MattiaFunnyM/Phone-Holder/Foxy Holder Topper v1.3mf

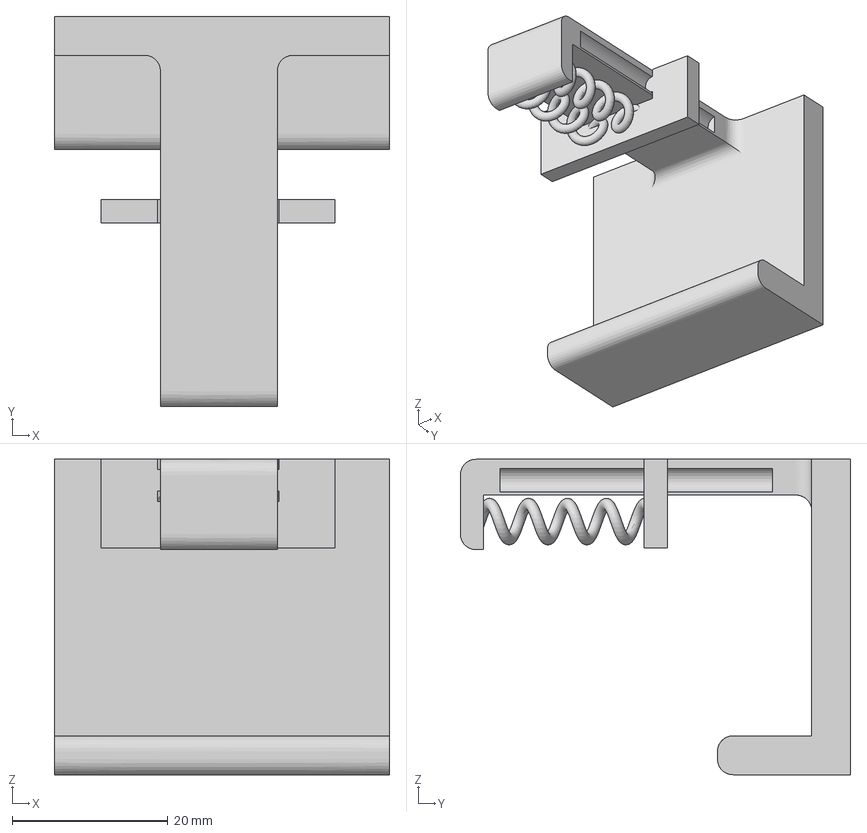
[picture p1: CAD file, 2025-06-15]
Foxy Holder Topper v1.3mf
43.0 x 50.1 x 40.5 mm
