MattiaFunnyM/Phone-Holder/Foxy Holder Stopper v1.3mf

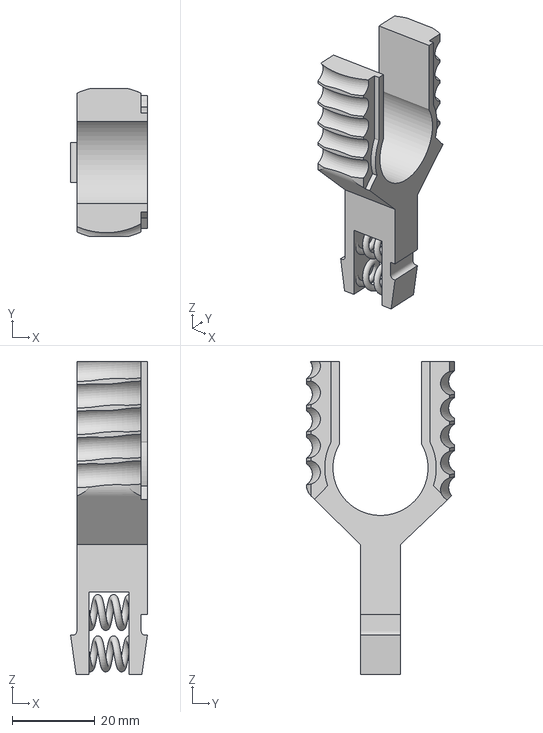
[picture p2: CAD file, 2025-06-08]
Foxy Holder Stopper v1.3mf
18.6 x 35.9 x 75.8 mm
