MattiaFunnyM/Phone-Holder/Foxy Holder Base v1.3mf

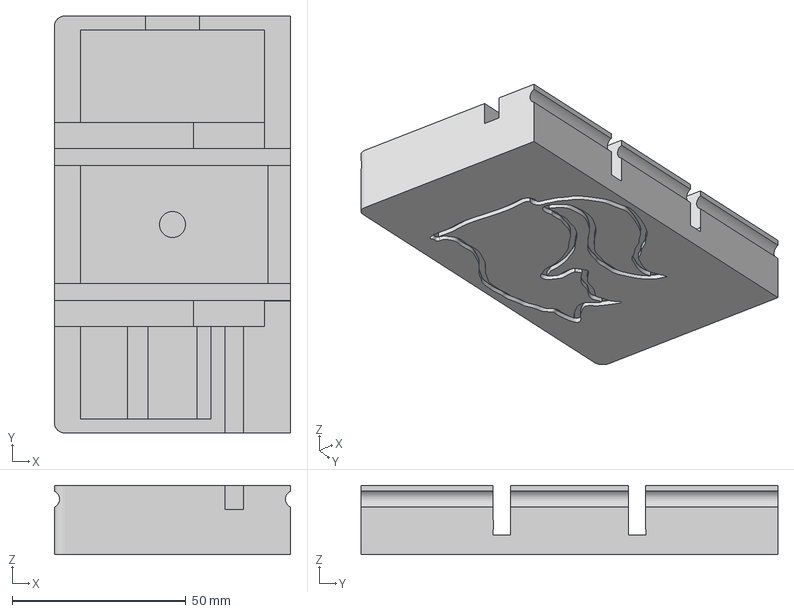
[picture p3: CAD file, 2025-06-06]
Foxy Holder Base v1.3mf
68.0 x 120.0 x 20.0 mm
