MattiaFunnyM/Phone-Holder/Foxy Holder Cover v1.3mf

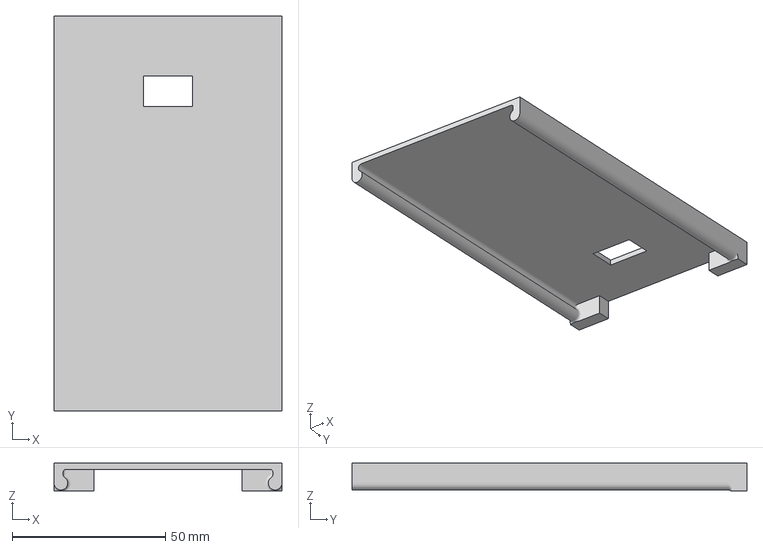
[picture p4: CAD file, 2025-06-05]
Foxy Holder Cover v1.3mf
74.5 x 129.0 x 9.00 mm
