MattiaFunnyM/Phone-Holder/Foxy Holder Inserimento 2 v1.3mf

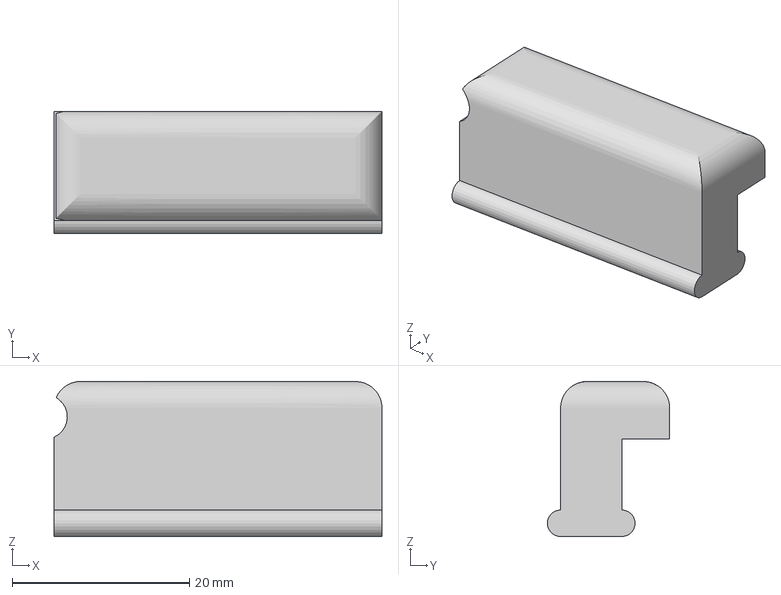
[picture p5: CAD file, 2025-06-04]
Foxy Holder Inserimento 2 v1.3mf
37.0 x 13.8 x 17.5 mm
