MattiaFunnyM/Phone-Holder/Foxy Holder Braccio Corto 2 v1.3mf

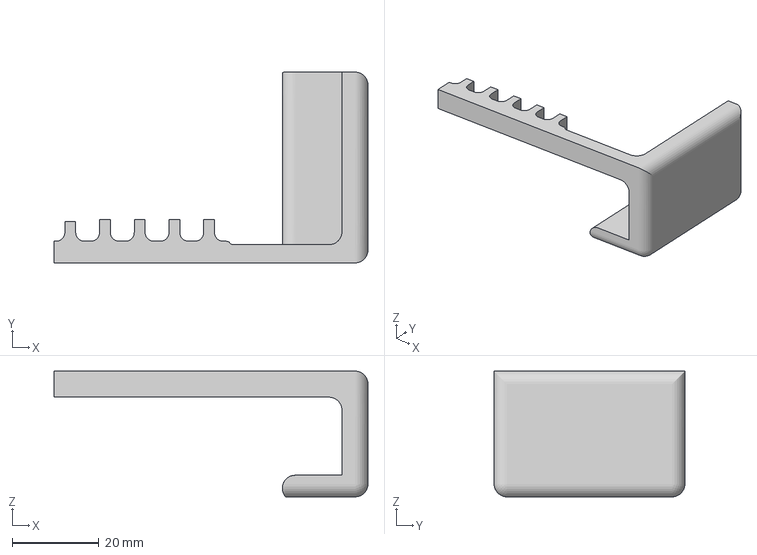
[picture p6: CAD file, 2025-06-04]
Foxy Holder Braccio Corto 2 v1.3mf
72.4 x 44.0 x 29.0 mm
