MattiaFunnyM/Phone-Holder/Foxy Holder Braccio Lungo v1.3mf

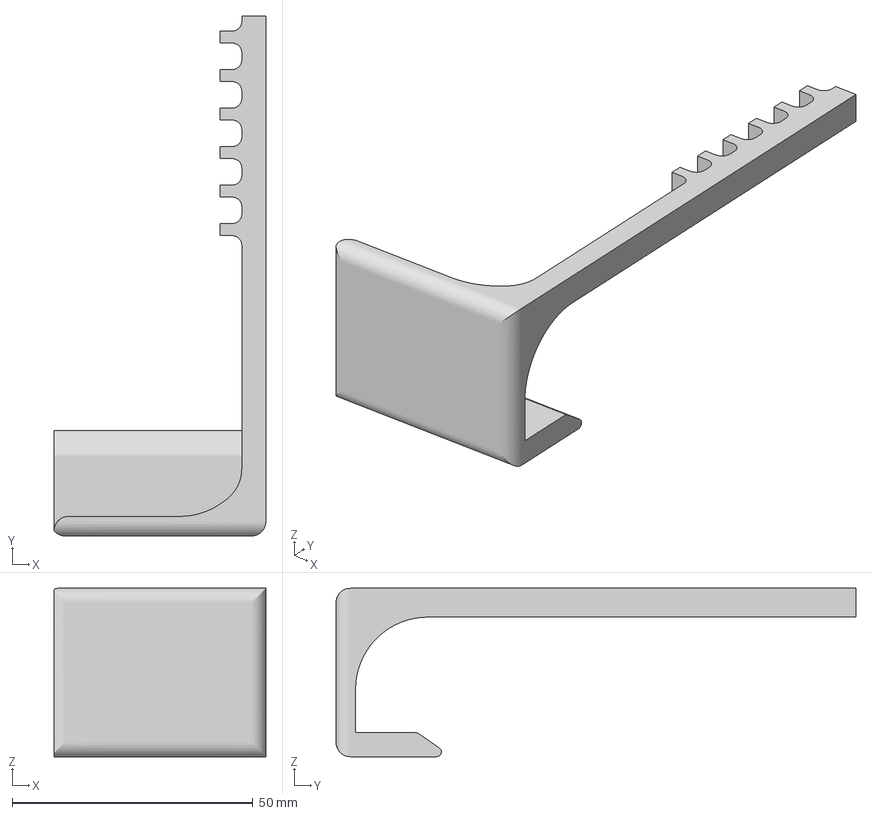
[picture p7: CAD file, 2025-06-03]
Foxy Holder Braccio Lungo v1.3mf
44.0 x 108.0 x 35.0 mm
