MattiaFunnyM/Phone-Holder/Foxy Holder Braccio Corto v1.3mf

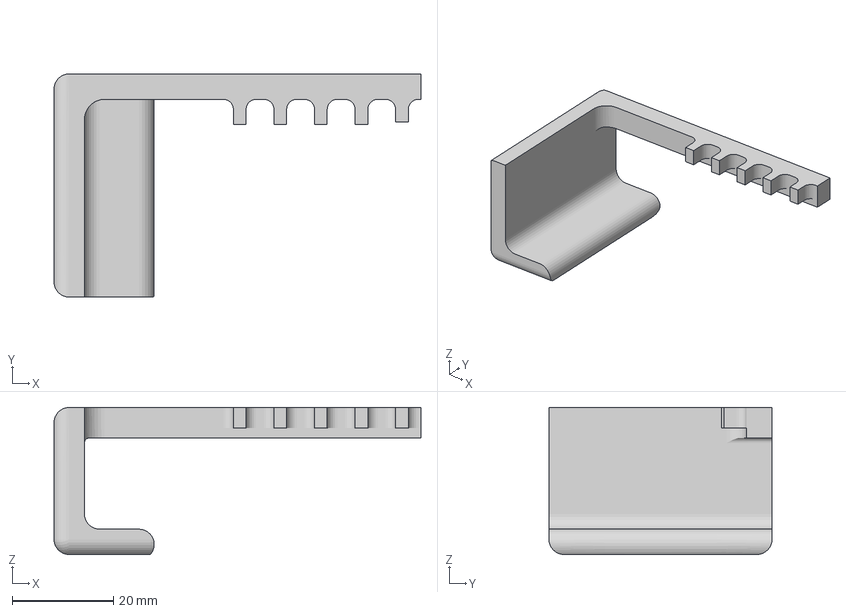
[picture p8: CAD file, 2025-06-02]
Foxy Holder Braccio Corto v1.3mf
72.4 x 44.0 x 29.0 mm
