MattiaFunnyM/Phone-Holder/Foxy Holder Rotella v1.3mf

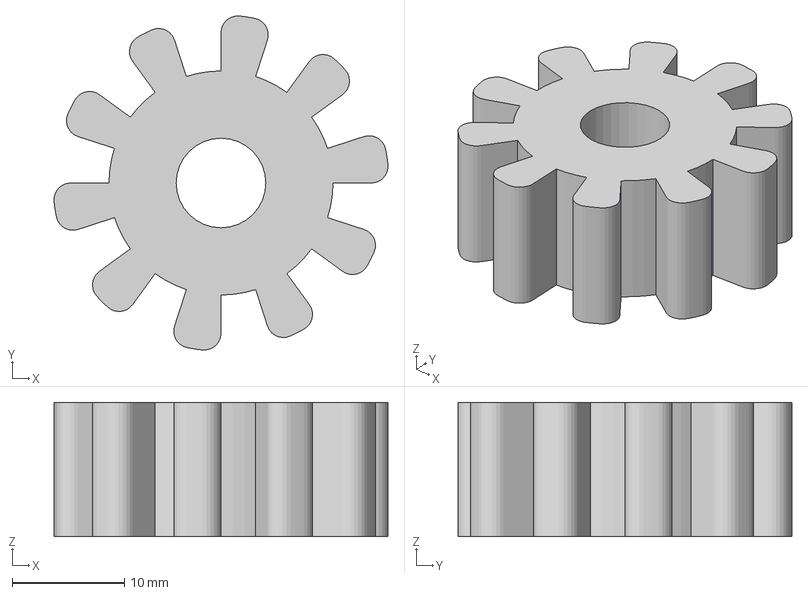
[picture p9: CAD file, 2025-05-31]
Foxy Holder Rotella v1.3mf
29.8 x 29.8 x 12.0 mm
