MattiaFunnyM/Phone-Holder/Foxy Holder Stopper Ring v1.3mf

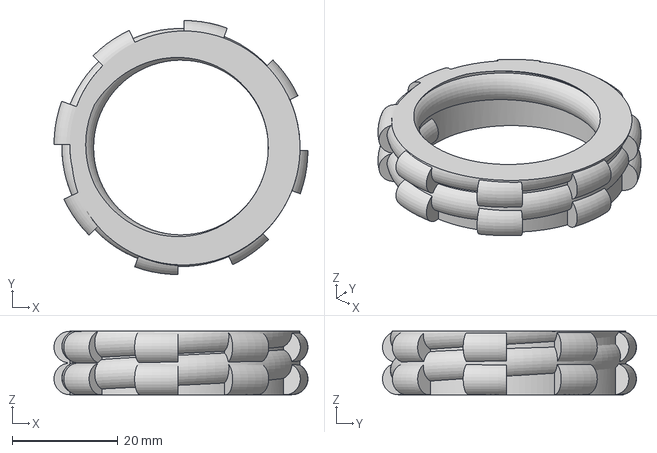
[picture p10: CAD file, 2025-05-31]
Foxy Holder Stopper Ring v1.3mf
48.0 x 48.0 x 12.0 mm
