MattiaFunnyM/Phone-Holder/(list of files, cad)

Other CAD files:
Foxy Holder Inserimento v1.3mf
