MattiaFunnyM/Phone-Holder/(commit log)

2025-05-31 Add files via upload
    Stopper Ring Added
    [Foxy Holder Stopper Ring v1.3mf]
2025-05-31 Add files via upload
    Rotella - Reduced height
    [Foxy Holder Rotella v1.3mf]
2025-06-01 Added Braccio Corto to the repository
    Adjusted dimensions to better hold the phone.
    Increase the number of saw teeth by 1.
    [Foxy Holder Braccio Corto v1.3mf]
2025-06-01 Add Braccio Lungo
    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
    [Foxy Holder Braccio Lungo v1.3mf]
2025-06-01 Add Base
    Base modified for be compliance with other modification
    [Foxy Holder Base v1.3mf]
2025-06-02 Improve Base
    1 mm Thicker
    Allow pieces to move closely and without jiggling
    [Foxy Holder Base v1.3mf]
2025-06-02 Braccio Corto Tooth Update
    Last Tooth of Braccio Corto was not completely etched. Problem solved
    [Foxy Holder Braccio Corto v1.3mf]
2025-06-02 Add inserimento to the repo
    Scale down to fit the box space
    [Foxy Holder Inserimento v1.3mf]
2025-06-03 Add Braccio Lungo to repo
    Braccio Lungo height was reduced to be able to hold the phone
    [Foxy Holder Braccio Lungo v1.3mf]
2025-06-03 Improve Holder Base
    Base Lungo and Base Corto are better positioned from the central wheel.
    Space of the Inserimento in the base are improved
    [Foxy Holder Base v1.3mf]
2025-06-04 Add Cover Files
    [Foxy Holder Cover v1.3mf]
2025-06-04 Braccio Corto Split in right and left
    Left Braccio corto (called Braccio Corto 2) is different because the central part is extruded away by 0.8 mm to insert it properly
    [Foxy Holder Braccio Corto 2 v1.3mf]
2025-06-04 Add a different inserimento for the right part
    [Foxy Holder Inserimento 2 v1.3mf]
2025-06-05 Improved Cover to insert into base
    - Hole on the lateral end of the cover to allow inserting it into the base
    - Cover is now perfectly symmetric
    - Cover size adjusted to adapt to the base
    [Foxy Holder Cover v1.3mf]
2025-06-05 Upload Stopper
    Stopper has springs in the base to try better fix it and reduce strong oscillation
    [Foxy Holder Stopper v1.3mf]
2025-06-05 Update Holder Stopper
    The base of the Stopper changed to have a hook part, It is also slightly larger. Orientation during print changed by consequence
    [Foxy Holder Stopper v1.3mf]
2025-06-06 Improved Holder Stopper
    The base of the holder was reduced in size because otherwise is not possible to insert in the cover
    [Foxy Holder Stopper v1.3mf]
2025-06-06 Foxy Holder Base Update
    Holder for mantaining the Stopper in correct position
    Change open area for Topper part
    [Foxy Holder Base v1.3mf]
2025-06-08 Foxy Holder Extender
    One Face is extender to make its print easier
    Dimension slightly change to improve insert
    [Foxy Holder Stopper v1.3mf]
2025-06-08 Introduced Topper
    Topper will stop phone from top part
    [Foxy Holder Topper v1.3mf]
2025-06-10 Topper Improver
    Dimension of the topper modifed to allow the phone to enter in position
    [Foxy Holder Topper v1.3mf]
2025-06-11 Topper Update
    The phone cannot enter once all the pieces are placed, so Topper should be updated to let the phone in!
    [Foxy Holder Topper v1.3mf]
2025-06-15 Topper Massive Update
    - Solve the bug that prints the spring too close to the structure
    - Change dimension to better fit the design
    - Create a channel for smoothly move the fixer
    [Foxy Holder Topper v1.3mf]
